rkoeppl/reprapboard/Odin_mainboard/mainboard.pdf

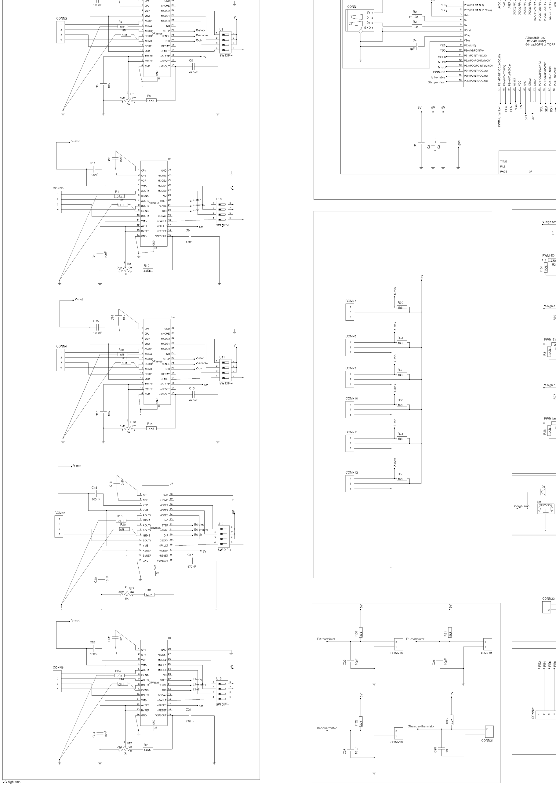
[picture p1: page 1]
