rkoeppl/reprapboard/Geri.driver_board/datasheets/RR.pinout.png

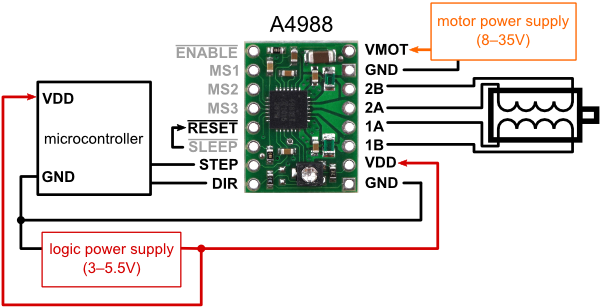
Geri.driver_board/datasheets/RR.pinout.png
