rkoeppl/reprapboard/Geri.driver_board/BOM/BAK/BOM_DRV8824_CSV.txt

Designation,Dimension,Distributor,Order-Number,Price(1)
R1,2k2/0.5W,RS-COMPONENTS,170-770,0.842
R2,0r47/1W,FARNELL,1838682,1.1600
R3,0r47/1W,FARNELL,1838682,1.1600
R4,10k/0.063W,RS-COMPONENTS,371-5137,0.035
R5,10k/0.063W,RS-COMPONENTS,371-5137,0.035
C1,470n/10V,RS-COMPONENTS,405-7785,1.50
C2,10n/50V,RS-COMPONENTS,712-8518,0.276
C3,100n/16V,RS-COMPONENTS,414-7125,0.984
C4,10n/50V,RS-COMPONENTS,712-8518,0.276
F1,3.5A/träge,RS-COMPONENTS,624-3102,0.81
