rkoeppl/reprapboard/Geri.driver_board/Schematics/Geri.Driver.Rev.b.0.01.pdf

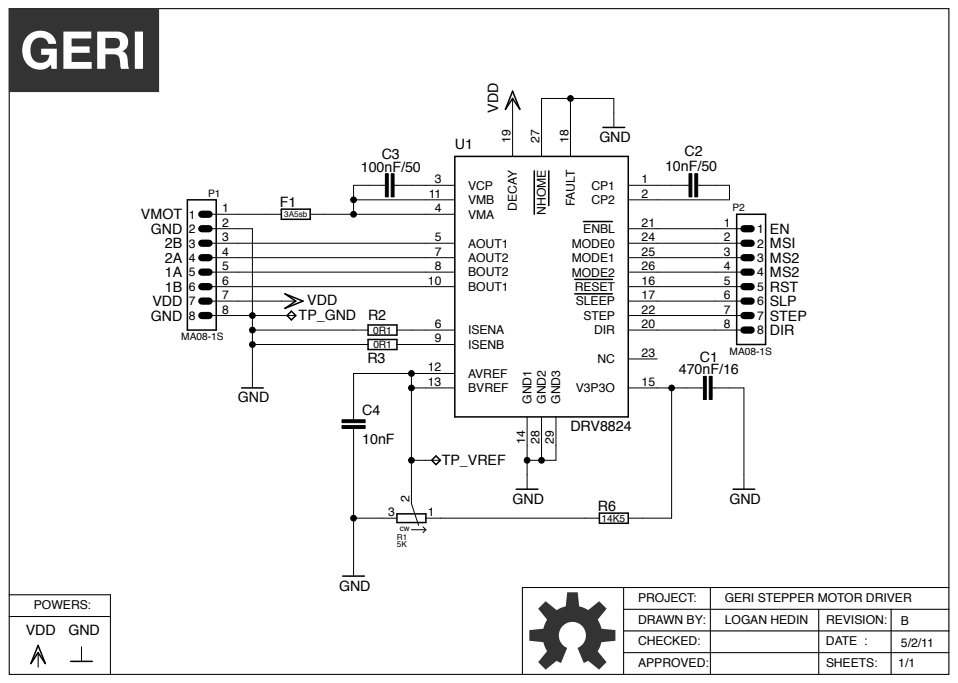
[picture p3: page 1]

PROJECT: | GERI STEPPER MOTOR DRIVER
DRAWN BY: | LOGAN HEDIN | REVISION: | B
CHECKED: | | DATE : | 5/2/11
APPROVED: | | SHEETS: | 1/1
