rkoeppl/reprapboard/Geri.driver_board/Schematics/Geri.Driver.Rev.a.0.01.pdf

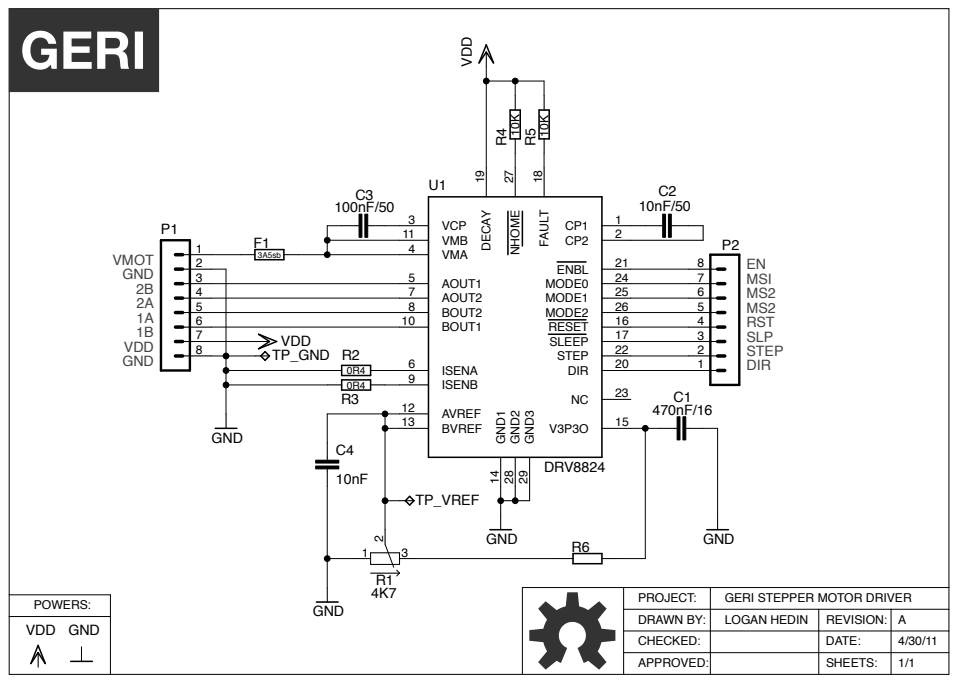
[picture p4: page 1]

PROJECT: | GERI STEPPER MOTOR DRIVER
DRAWN BY: | LOGAN HEDIN | REVISION: | A
CHECKED: | | DATE: | 4/30/11
APPROVED: | | SHEETS: | 1/1
