rkoeppl/reprapboard/Geri.driver_board/Schematics/drv8824_board.OLD.REV.pdf

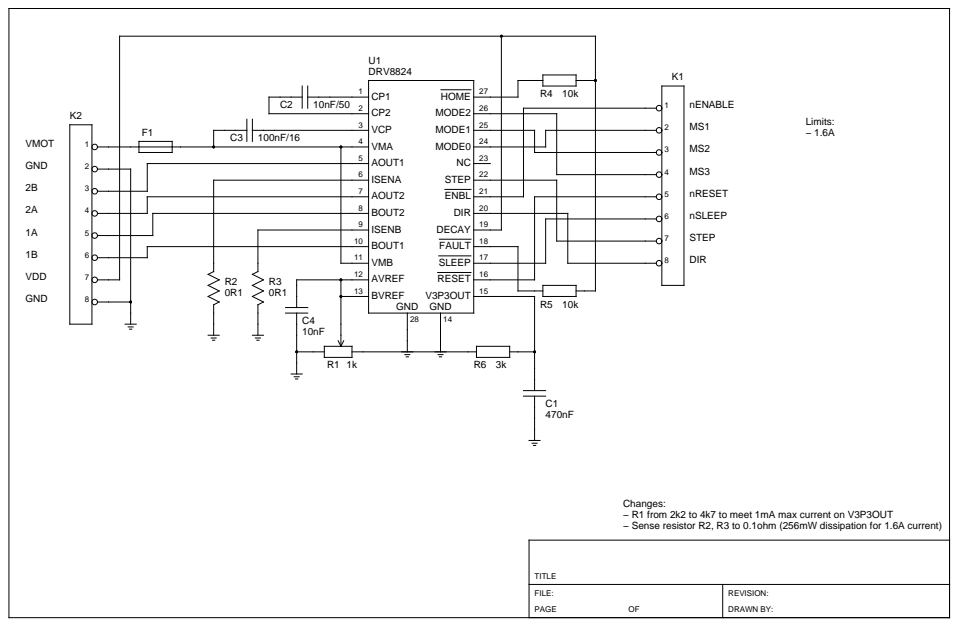
[picture p5: page 1]

Changes:
− R1 from 2k2 to 4k7 to meet 1mA max current on V3P3OUT
− Sense resistor R2, R3 to 0.1ohm (256mW dissipation for 1.6A current)

# drv8824_board.pcb

# 1. Table of Contents (This Page) Created on Fri Mar 18 20:42:02 2011

# 2. component 3. solder 4. plated-drill 5. componentmask 6. soldermask 7. topsilk 8. bottomsilk 9. bottompaste 10. toppaste 11. topassembly 12. bottomassembly 13. fab

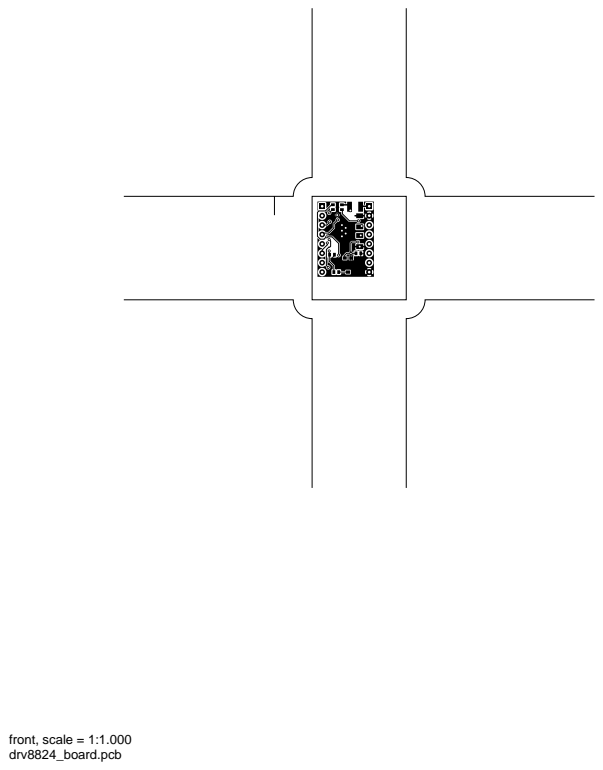
[picture p6: page 3]
front, scale = 1:1.000

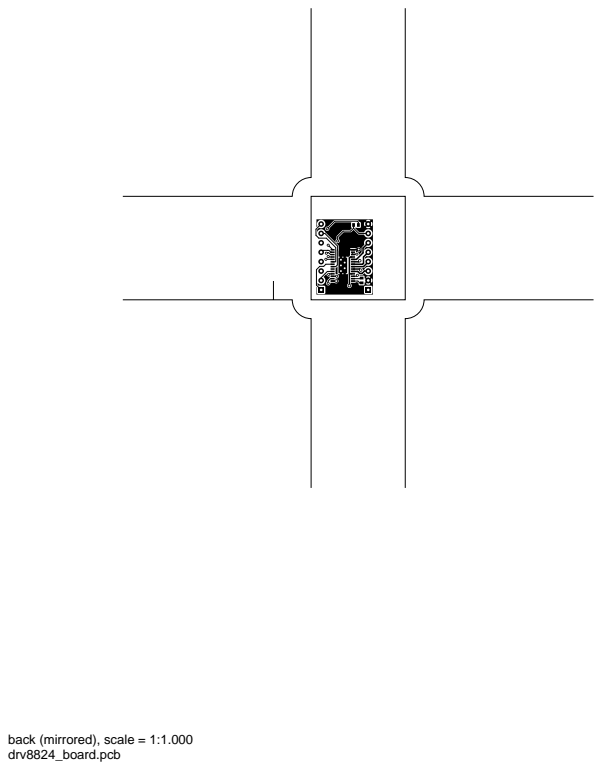
[picture p7: page 4]

back (mirrored), scale = 1:1.000

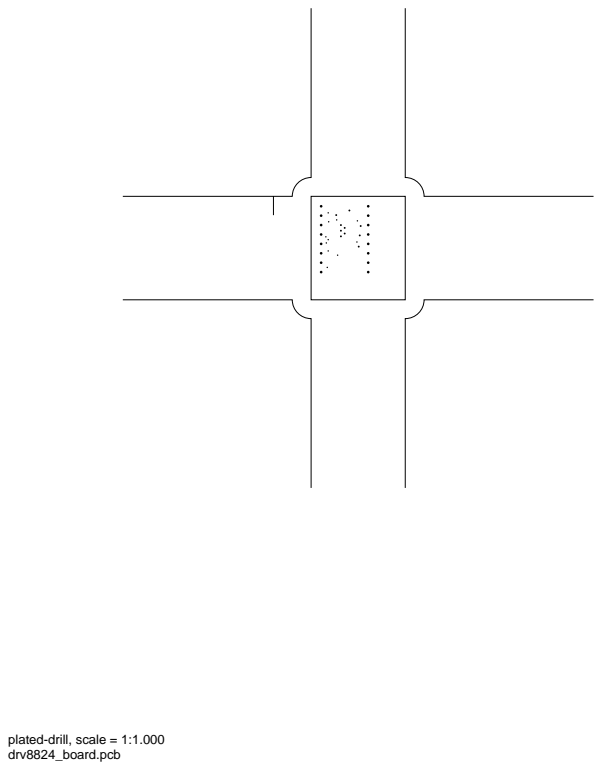
[picture p8: page 5]

plated-drill, scale = 1:1.000

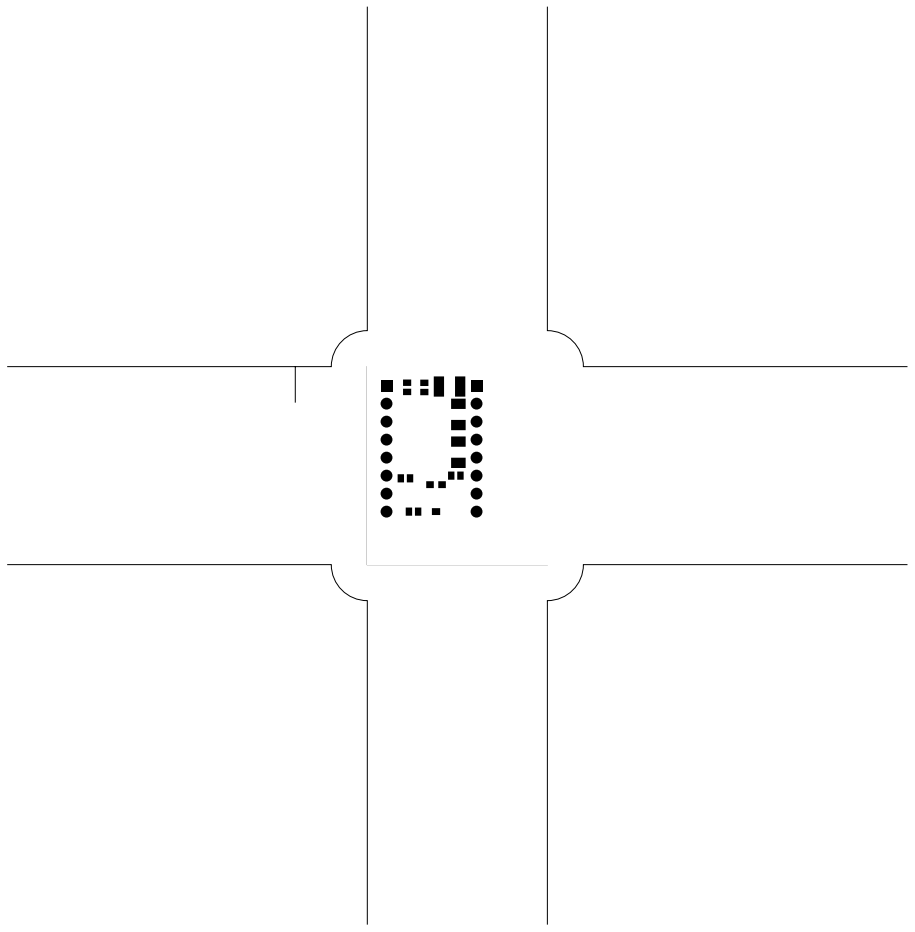
[picture p9: figure]

frontmask, scale = 1:1.000

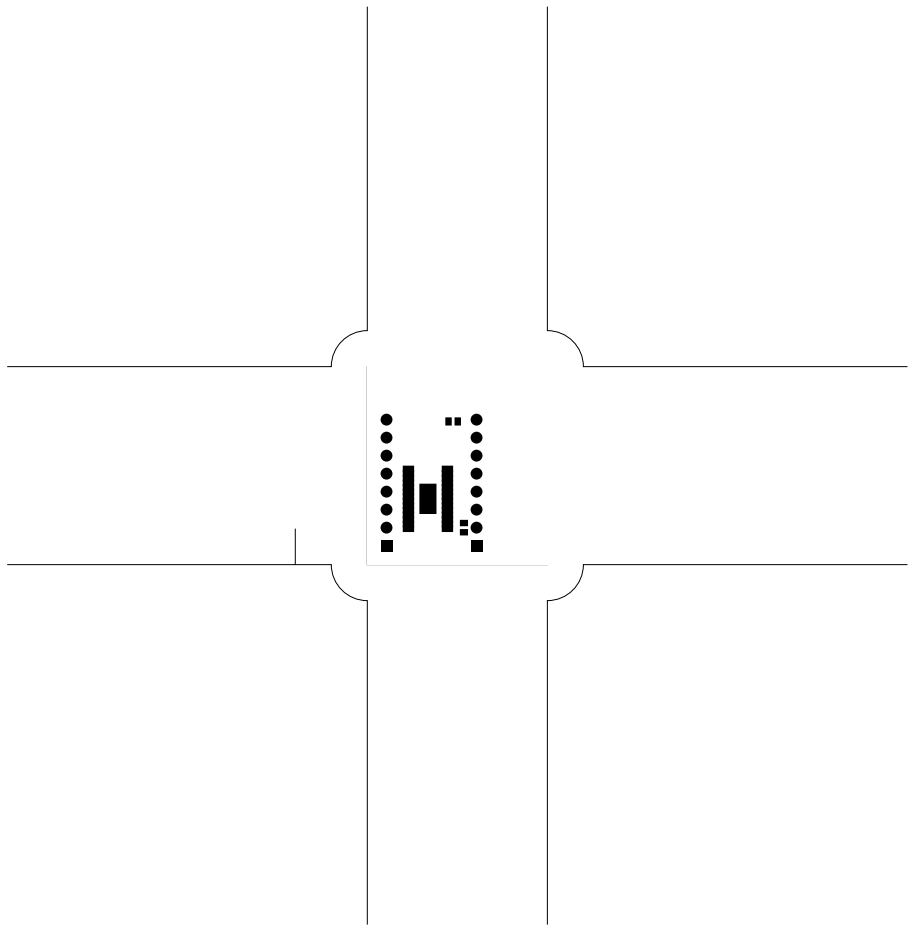
[picture p10: figure]

backmask (mirrored), scale = 1:1.000

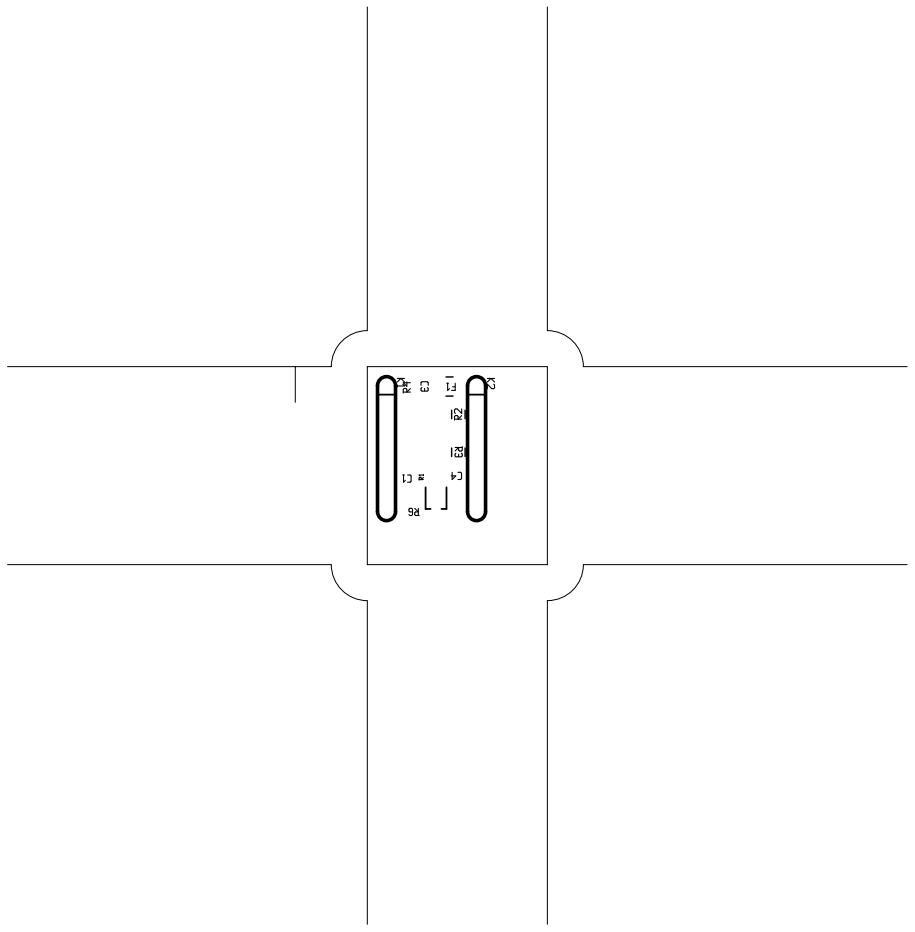
[picture p11: figure]

frontsilk, scale = 1:1.000

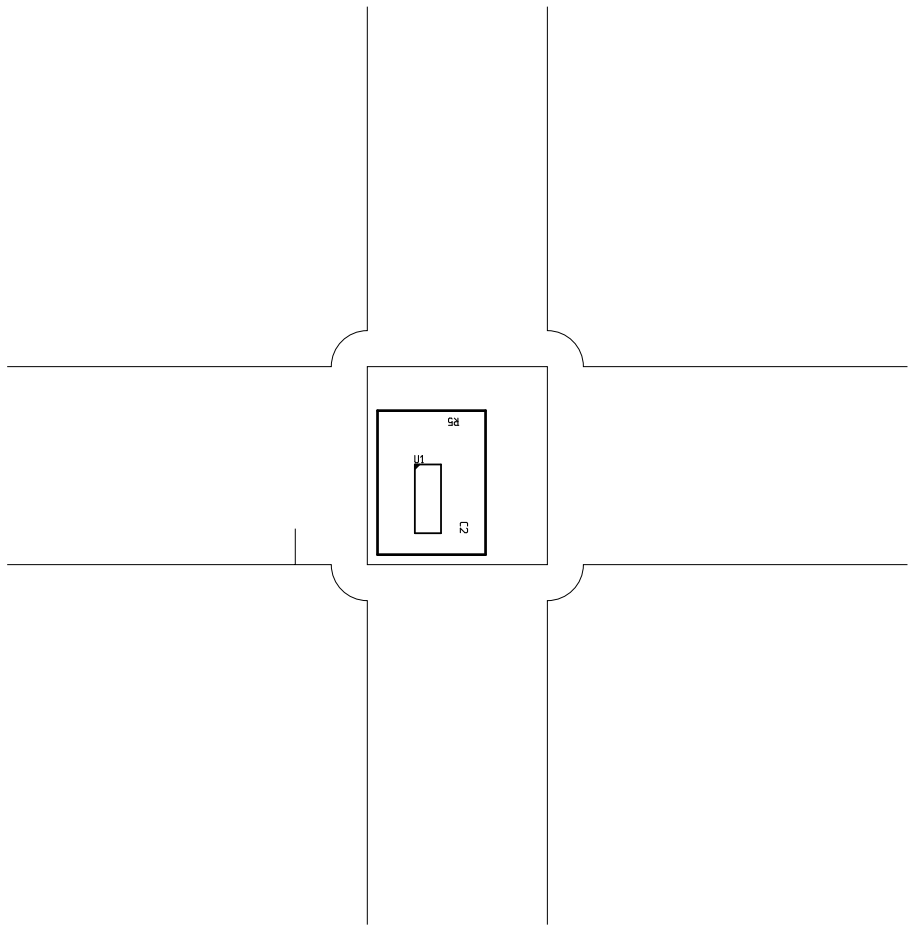
[picture p12: figure]

backsilk (mirrored), scale = 1:1.000 backpaste (mirrored), scale = 1:1.000 frontpaste, scale = 1:1.000

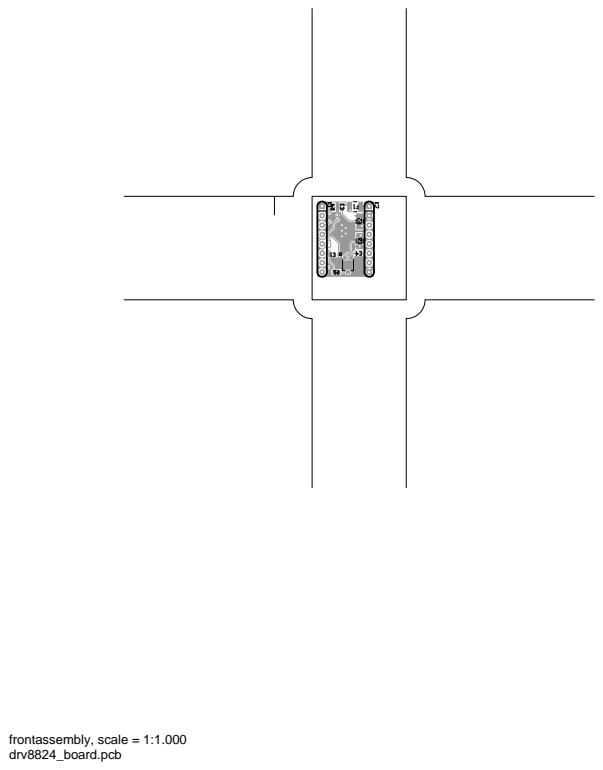
[picture p13: page 12]
frontassembly, scale = 1:1.000

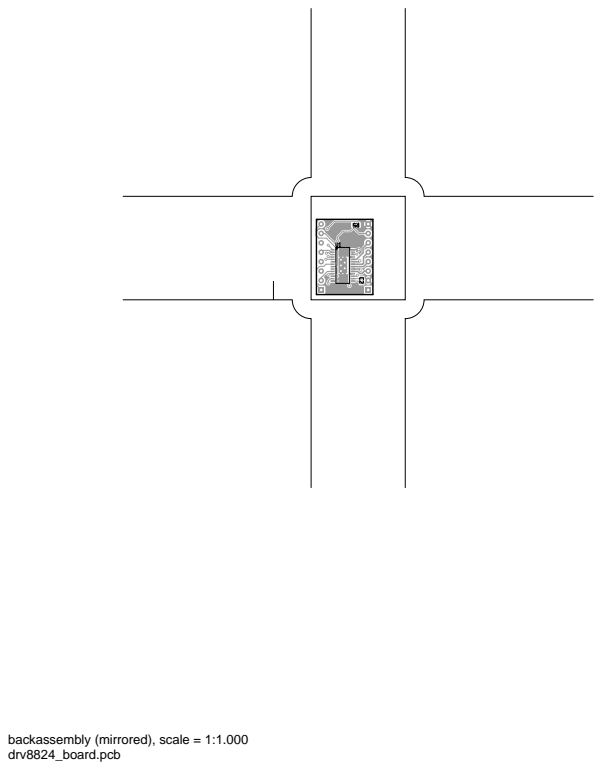
[picture p14: page 13]

backassembly (mirrored), scale = 1:1.000

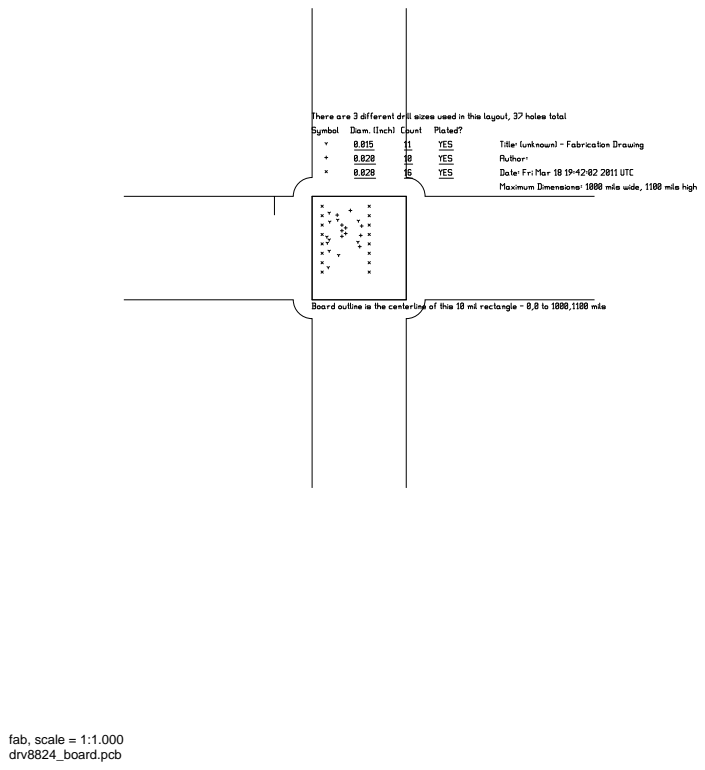
[picture p15: page 14]
fab, scale = 1:1.000
