rkoeppl/reprapboard/Odin_mainboard/Odin/Odin.sch

## KiCad design Odin_mainboard/Odin/Odin.sch (2014-05-11)

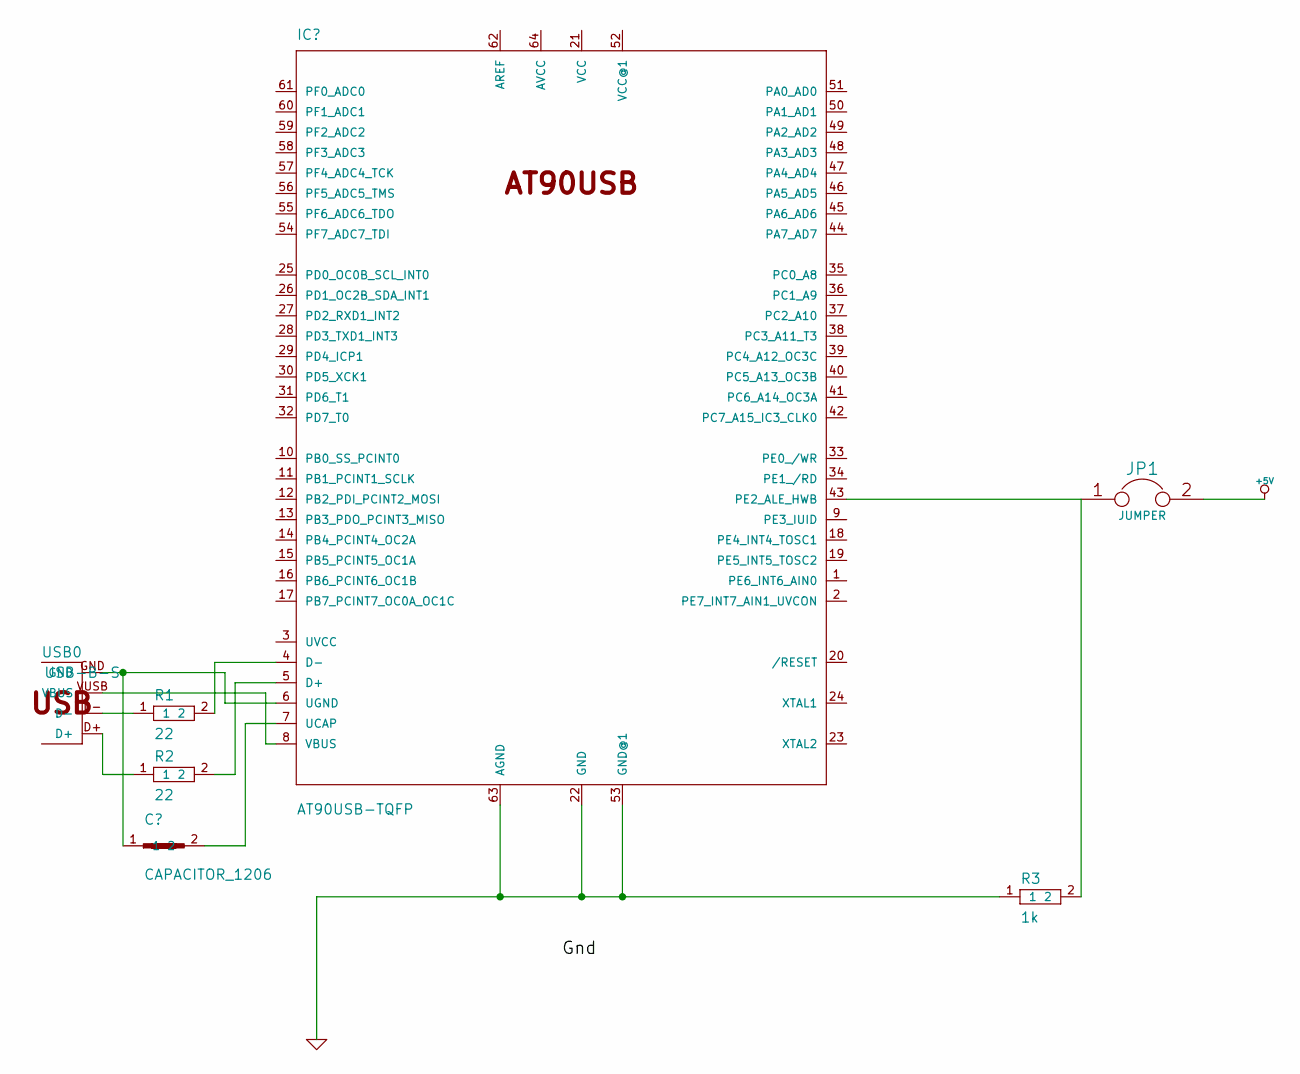
[picture p16: schematic Odin.sch]

Parts:
JP1: JUMPER
R1, R2: 22; ipc-7351-resistor-RESC3115X70N
R3: 1k; ipc-7351-resistor-RESC3115X70N
USB0: USB-B-S; con-usb-USB-B-SMT

Connections:
+5V: JP1.2
Gnd: R3.1
unnamed: JP1.1, R3.2
unnamed: R1.1, USB0.D-
unnamed: R2.1, USB0.D+
