rkoeppl/reprapboard/(commit log)

2011-04-26 added board design studies and BOM from ueberramps~
2011-04-26 added schematics from google docs
2011-04-27 Authored BOM, cleaned dir for Geri driver.
2011-04-27 commited BOM cleaned up Geri files added datasheets
    [Geri.DRV.BOM.REV.A.ods, Geri.DRV.BOM.REV.A.xls]
2011-04-27 removed old Geri.OLD.BOM.xls
    [Geri.DRV.BOM.REV.A.xls]
2011-04-28 started ref design calc for Geri
    [Geri.Calculator .ods]
2011-04-28 added design guide, merged logans changes
    [Geri.DRV.BOM.REV.A.ods]
2011-04-29 changed all text doc to utf8 plain text added design noted to Geri doc updated fab notes
    [Geri.Calculator .ods]
2011-05-01 added schematic updated dir added notes
    [Geri.Calculator .ods, Geri.DRV.BOM.REV.A.ods]
2011-05-01 commited doc for geri driver added todo and requirments
2011-05-14 edited schematic and updated calc for GERI driver
    [Geri.Calculator .ods, Geri.DRV.BOM.REV.A.ods]
2011-05-14 updated GERI files for schematic and calc
2011-08-15 added symbol for drv8825
    [pinbelegung.ods, pinbelegung_drv8825.csv, pinbelegung_drv8825.ods, test.sch]
2011-08-15 some updates
    [drv8825.csv, drv8825.ods]
2011-08-15 created working environment voe gschem, added working symbol for drv8824/drv8825
    [drv8825.csv, drv8825.ods, pinbelegung.ods, pinbelegung_drv8825.csv, pinbelegung_drv8825.ods, ti-drv8824_8825.csv]
2011-08-15 started actual mainboard developement. transcribed the schematics for the driver section from the geri revision B
    [mainboard.sch]
2011-08-16 continued work on mainboard, added MCU
    [mainboard.sch]
2011-08-19 cleanup, added Teensylu schematics for reference, added USB-connector-symbol
    [mainboard.sch]
2011-08-20 updated component labels on ddirver section, added USB-connector
    [mainboard.sch]
2011-08-20 further work on MCU-connections. defined all nets needed on MCU
    [mainboard.sch]
2011-08-20 continued work on mainboard. added Step. Dir and enable nets to driver section
    [mainboard.sch]
2011-08-20 fixed wrong pin assignments. thanks to Triffid_Hunter for his help
    [mainboard.sch]
2011-08-20 added schematics and net for endstops, added schematics and net for stepper faulr. Thanks to EvdZ for pointing out that no or-gate is needed for this type of stepper drivers
    [mainboard.sch]
2011-08-20 added thermistor circuitry and Heater circuitry including mosefts. defined required nets for those
    [mainboard.sch]
2011-08-20 removed fuses from driver section. they do not make too much sense on components solderd in place - thankls to ParCan for that insight. they where a leftover from the geri schematics. include somethi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
    [mainboard.sch]
2011-08-21 cleaned up some errors in driver schematics pointed out by EvdZ, disconnected VCC from USB - we are self powered
    [mainboard.sch]
2011-08-31 Added voltage regulator ans power supply schematics, added LEDs for mosfets
    [mainboard.sch]
2011-09-04 recreated schematics pdf
2011-09-29 corrected connection of potentiometer for the drivers, dropped support for 12V endstops
    [mainboard.sch]
2011-11-10 added dip-switches to select MS-mode added pullups for the endstops
    [mainboard.sch]
2012-05-16 protection against wrong porarity redone after hint by STB from reprap forum. Schematics similar to http://www.lothar-miller.de/s9y/categories/39-Verpolschutz lowest example. recreated pS and PDF
    [mainboard.sch]
2012-05-17 redesigned Mosfet connections fpr better protection. inspiration taken from RAMPS 1.4
    [mainboard.sch]
2012-05-17 specified diode for polarity protection
    [mainboard.sch]
2012-05-17 finished thermistor circuitry
    [mainboard.sch]
2012-05-17 continued specifying footprints
    [mainboard.sch]
2012-05-20 added more information about component size
    [mainboard.sch]
2012-05-20 renamed DIP-switches to SW1-SW5
    [mainboard.sch]
2012-05-20 definition of connector fiitprints started
    [mainboard.sch]
2012-05-21 defined footprint of dip switches
    [mainboard.sch]
2014-05-11 started conversion to KiCad
    [Odin.sch]
